Grelbatron/MidiEvil/MidiEvil User Manual.pdf

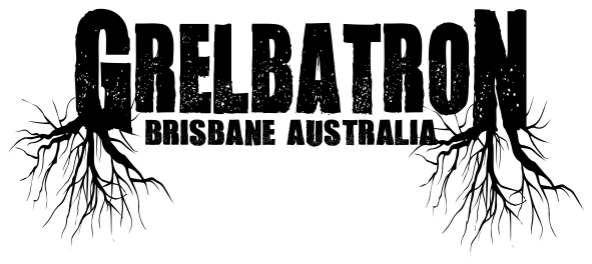
[picture p1: figure]

MidiEvil User Manual.docx | 1

## MidiEvil | User Manual

MidiEvil is a dirt simple midi-controlled loop and amp switch. It’s been designed to be easy to configure and can be used with or without a midi controller.

## Features

- Switchable Input Buffer (Based on Klon)
- 4 True Bypass Loops using good quality NEC Signal Relays (Switches 1 – 4)
- 1 Normally Open Latching Relay (Switch 5)
- 2 Footswitch Modes (Direct or Program)
- Program Mode allows you to recall 10 presets across 2 banks
- Direct Mode allows for control over each loop and amp switch
- User assignable CC Numbers to each Switch
- Controller values from 0-63 will switch off the output, values from 64-127 will switch it on
- Can store up to 128 presets (not that you’ll need that many)
- Ability to enable and disable CC switch control and PC recall functionality
- 1 Midi In Connector (5 Pin Din)
- 3 Midi Through Connectors to pass your midi control signals through to other devices (5 Pin Din)

## Controls And Connections

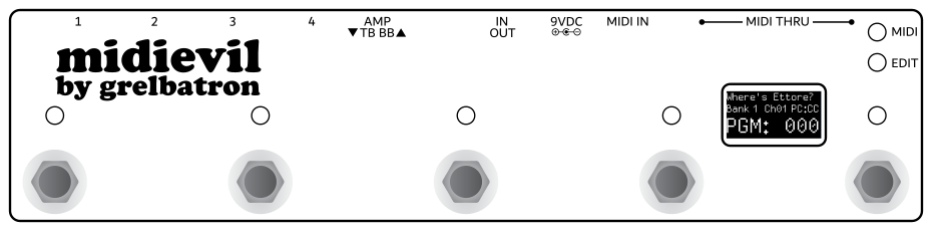
[picture p2: figure]

REAR PANEL
Loops 1 – 4 are left to right with the send indicated in Black and return is indicated in RED Normally open Latching Switch is indicated by Green
The toggle switch changes between Buffered Bypass (BB) or True Bypass (TB)
The Input is indicated in Black and the Output is Metallic Silver
Standard 9VDC 2.1mm Centre Negative Power Connection (200mA) Standard 5 Pin Din Midi Input and 3 x 5 Pin Midi Thru Connectors

FACE
5 x momentary footswitches for Program or Direct Switch Recall
5 x LEDS above footswitches indicate the LOOP (1 – 4) and Latching switch (5) state. Midi LED Flashes when incoming Midi Data is received
Edit LED is on in Edit mode, and flashes on and off when in preset bank 2 of PGM mode 1” Display shows operating details during use, and to assist with configuration of device

FRONT PANEL
2 Momentary Buttons for Configuration and Bank Select
The Top Button will be referred to as Button 1
The Lower Button will be referred to as Button 2

## Footswitch Mode: Program Operation

Program mode enables the 5 momentary footswitches to recall 10 presets/programs across 2 banks. The Edit LED flashes ON/OFF in 500ms intervals to indicate when bank 2 is engaged. Midi Control can be used in unison.

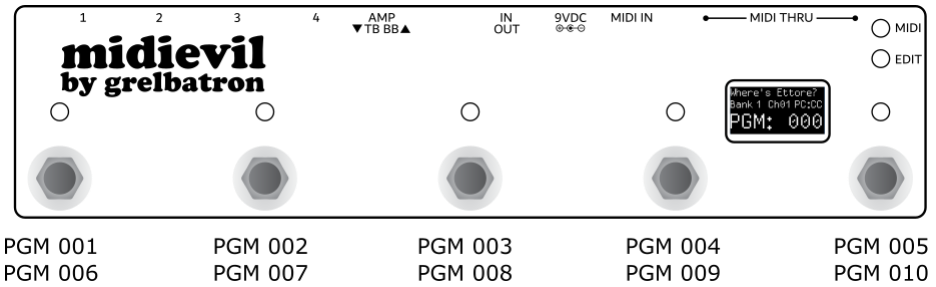
[picture p3: figure]
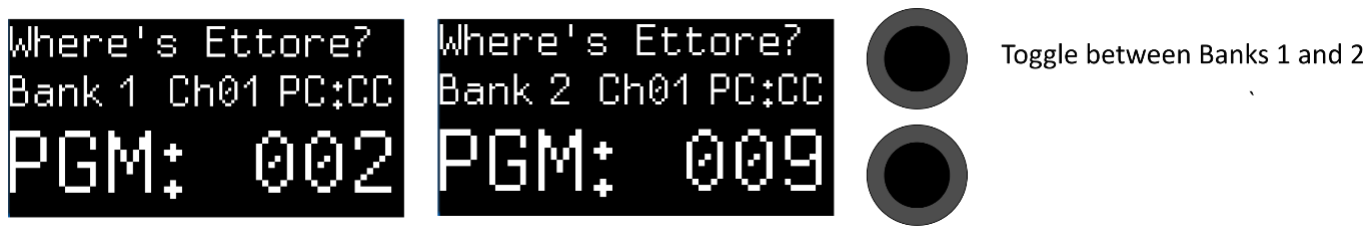
[picture p4: figure]

Programs 0 – 128 can be saved to the device. PGM 000 being the startup preset, PGM 001 – 010 are recallable via footswitches in PGM mode, and presets 1 – 128 can be recalled via midi.

## Footswitch Mode: Direct Operation

Direct mode enables access to engage each loop and latching switch from the 5 momentary switches. Midi Control can be used in unison.

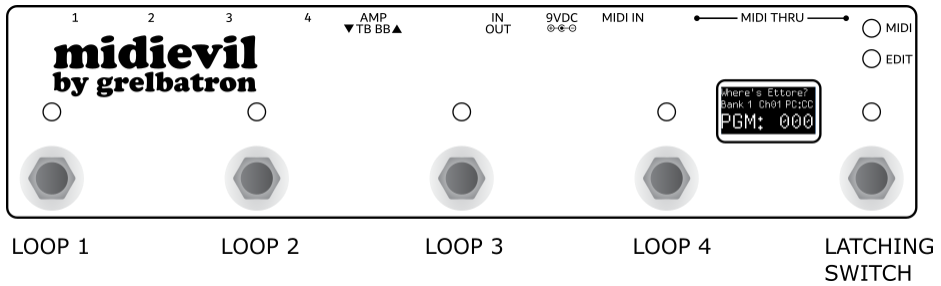
[picture p5: figure]

## Display and Configuration

DISPLAY IN STANDARD OPERATION (PGM Mode)

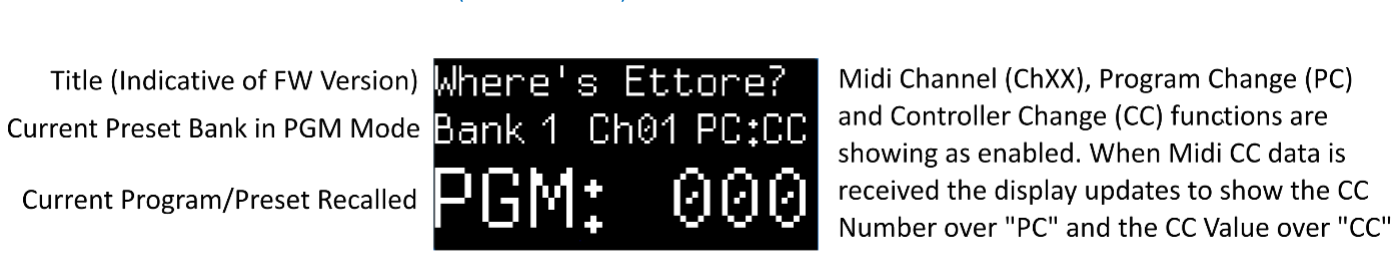
[picture p6: figure]

DISPLAY IN STANDARD OPERATION (DIR Mode)

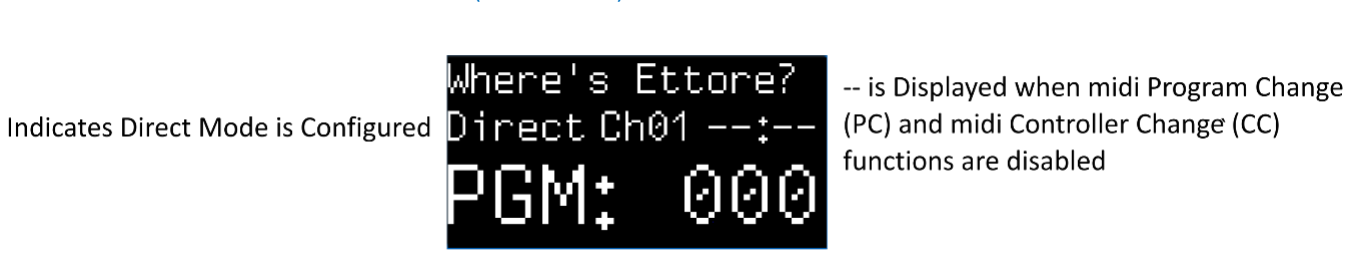
[picture p7: figure]

* PGM 000 is not recallable via Midi and is loaded on powering the device. It can be edited and saved to customize your startup configuration.

DISPLAY IN EDIT MODE

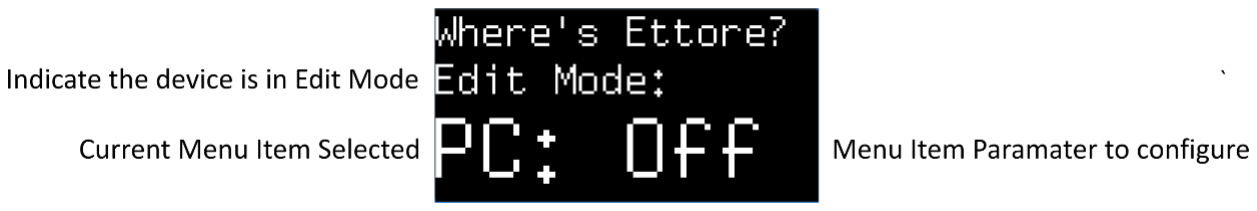
[picture p8: figure]

BUTTON FUNCTION MATRIX
Button # | Button Function | Operation | Edit
Button 1 | Quick Press | Bank Toggle (PGM Mode Only) | Cycle Edit Menu Option
Button 1 | Press and Hold | Enter Edit Mode | Save and Exit Edit Mode
Button 2 | Quick Press | | Toggle/Increment Current Parameter
Button 2 | Press and Hold | | Increment controller numbers by 10

ENTERING EDIT MODE
* All Midi controls sent to the device will be ignored when in edit mode.

ENABLING MIDI PROGRAM CHANGE
The Program Change function allows the device to receive program change midi commands. Turn it off if you do not want the device to change preset/programs when receiving midi commands.

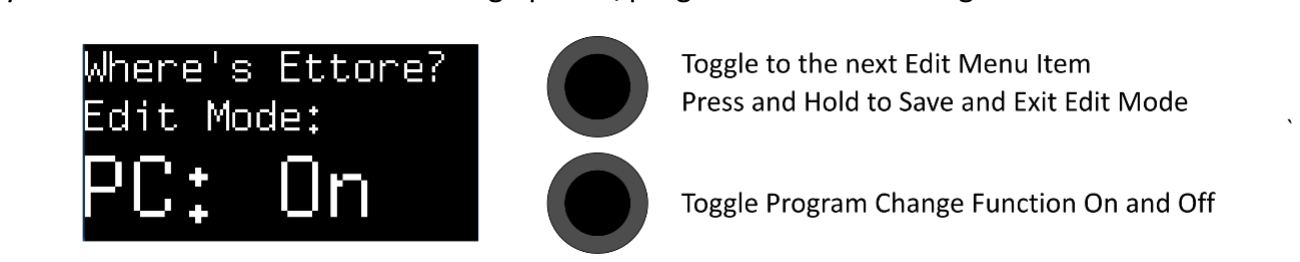
[picture p9: figure]

ENABLING MIDI PROGRAM CHANGE
The Control Change function allows the device to receive control change midi commands on the configured channel. Each switch can have an independent controller assigned. Values 0-63 turn the switch off and values 64-127 turn the switch. Turn it off if you do not want the device to switch when receiving CC midi commands.

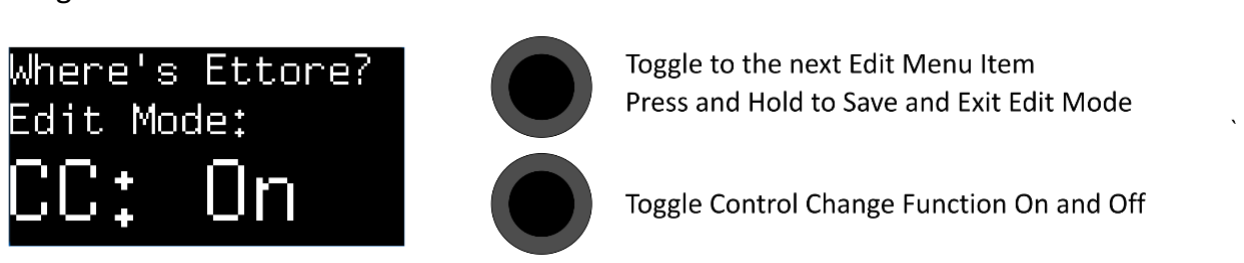
[picture p10: figure]

CHANGING FOOTSWITCH MODE
There are two operational Footswitch Modes. Direct (DIR) allows for control over each Loop and Latching Relay. Program (PGM) allows for recall of presets 1-5 in Bank 1 and 6 – 10 in Bank 2.

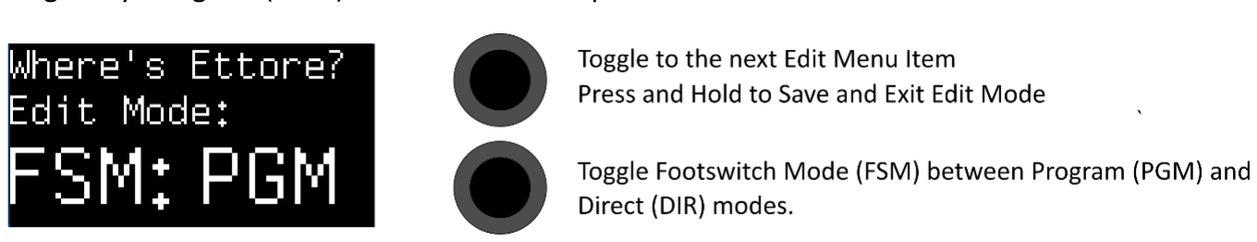
[picture p11: figure]

CHANGING MIDI CHANNEL
The Device can be configured to a suitable Midi Channel for your setup

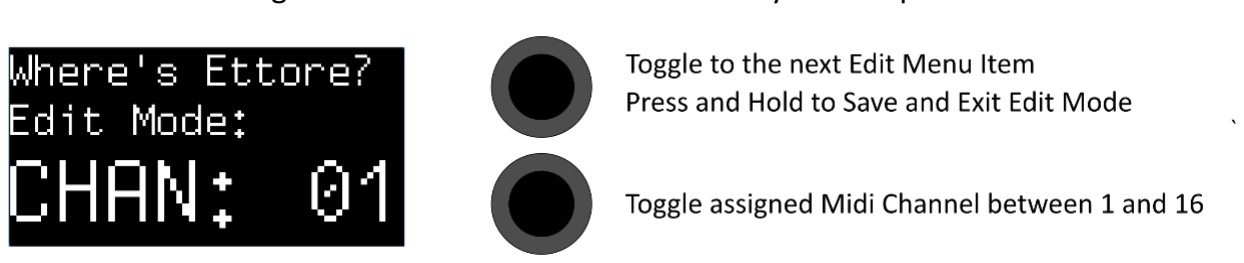
[picture p12: figure]

ASSIGNING MIDI CONTROLLER NUMBERS
With the control change function enabled, it’s possible to assign each loop and latching relay with its own Controller.

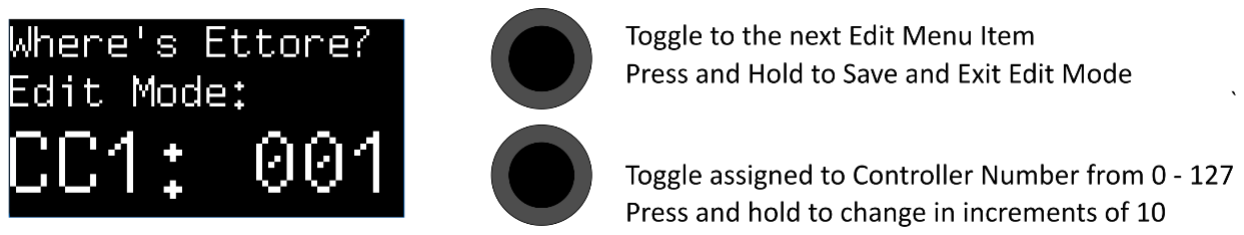
[picture p13: figure]

SAVING PROGRAMS/PRESETS

Recall Program number you would like to save over
- PGM Mode: Select Bank and Preset via Switches
- DIR Mode: Set Preset via external midi command

Start Edit Mode by pressing and holding BUTTON 1

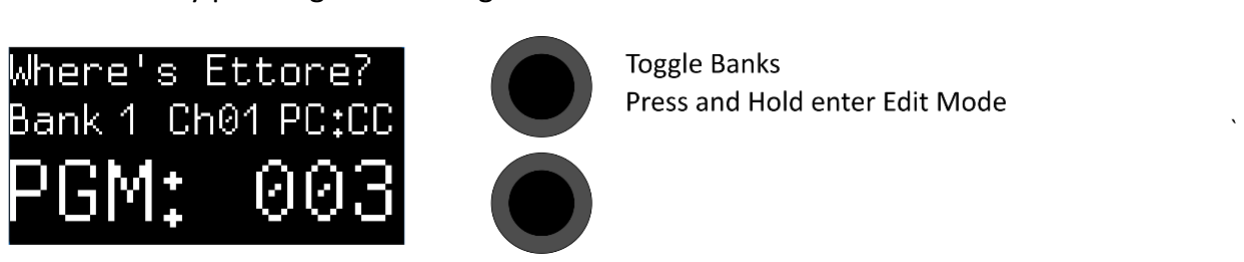
[picture p14: figure]

Whilst in Edit Mode use the Footswitches to engage or disengage each loop and latching relay to the desired state. The LED’s being on indicate the loop or latching switch associated is on/engaged. The screen will show what preset is going to be saved over.

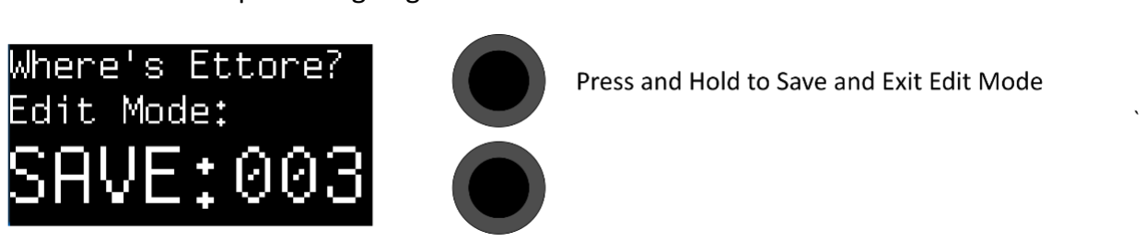
[picture p15: figure]

## Firmware Updates

DOWNLOAD AND EXTRACTION

*Currently only updates with Windows is supported
*Require a USB Mini Type B – Type A Cable
* Processor and screen will power via the USB connection, however the relays and LED’s require the external 9VDC supply to function. It is not required to connect an external 9VDC supply to the device for FW updates.

Firmware is simple to update if ever required. The Firmware and Updater are all packaged into a single .exe file and available online at https://linktr.ee/grelbatron

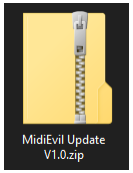
[picture p16: figure]
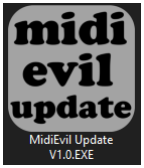
[picture p17: figure]

The updater will be downloaded in a .zip folder Right Click the folder and “Extract All…”
Save the extracted folder to you preferred location Within the extracted folder you will find the .exe

CONNECTION AND UPLOAD

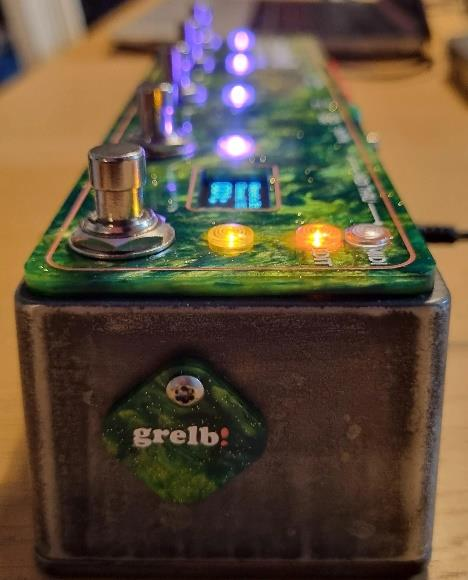
[picture p18: figure]

Gently rotate the USB cover on the right side of the enclosure Connect the USB Mini Type B Connector to the Device Connect the USB Type A to your Computer
Double Click the Update.exe
If you get the below Defender Caution select “Run Anyway”

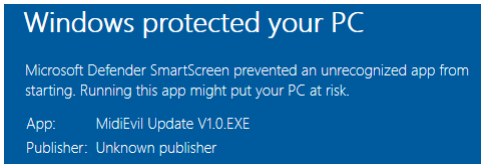
[picture p19: figure]

The Updater will start up but not run. Take this chance to double check all connections are in place and that there are no other USB devices connected to the PC.

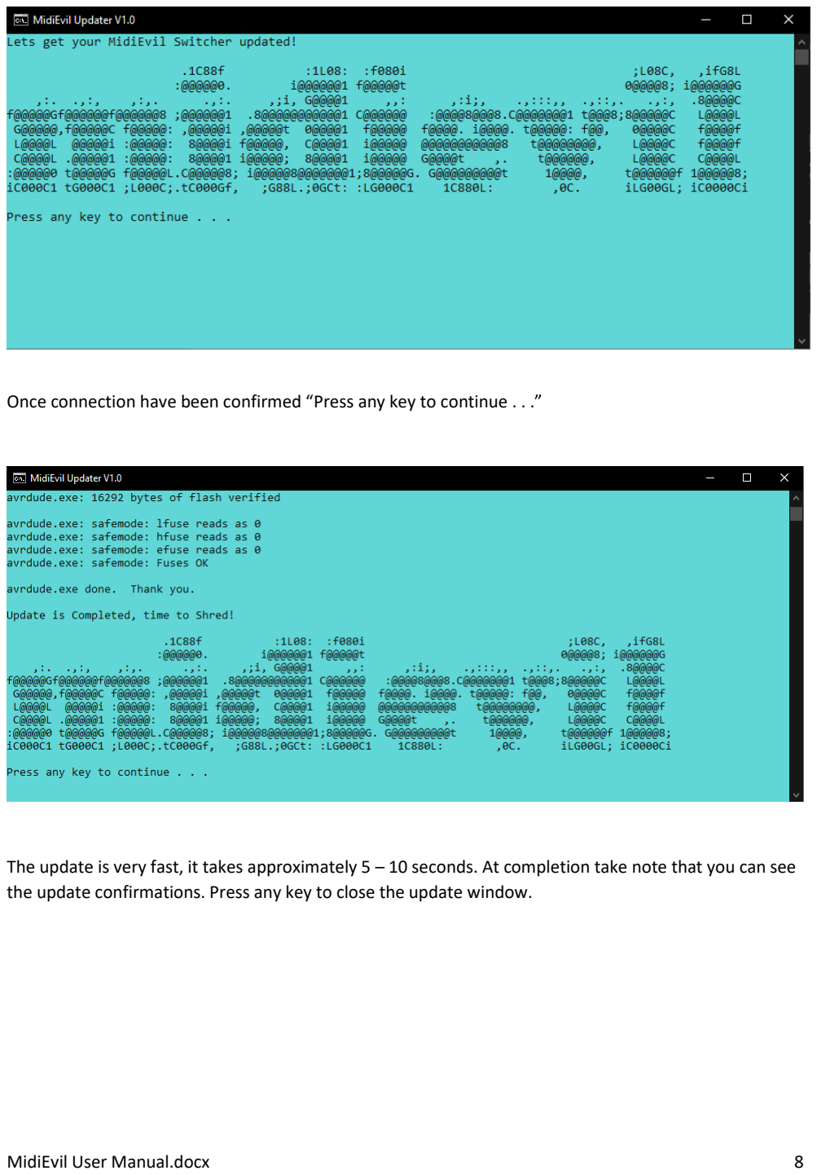
[picture p20: page 8]

Once connection have been confirmed “Press any key to continue . . .”

The update is very fast, it takes approximately 5 – 10 seconds. At completion take note that you can see the update confirmations. Press any key to close the update window.

### Full Build Warranty

Grelbatron will repair your product if it fails to operate due to defects in materials or workmanship for a period of two years from date of purchase. Except for the LED display which is warranted for 6 months.

Exclusions of this warranty may include:

- Damage caused by misuse, abuse, or unauthorized modification.
- Aesthetic damage such as surface scratches.
- Damage caused by other products.
•
- Postage and shipping charges.

Please lodge warranty claims direct to grelbatron@gmail.com with a description of the fault and any relevant photos.

Follow me on Instagram

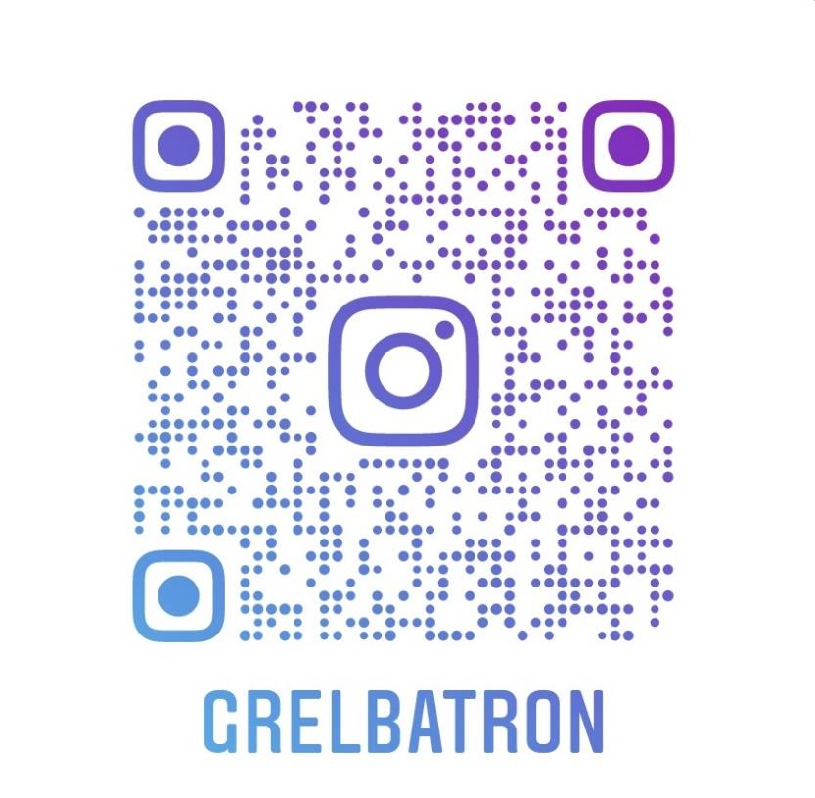
[picture p21: figure]
